crisandaniela/Generator-Semnal-OrCAD/Crisan_Diana_Daniela_2121.pdf

## GENERATOR DE SEMNAL TRIUNGHI-DREPTUNGHI

## 1. Introducere și Principiul de Funcționare

Generatoarele de semnal capabile să genereze simultan forme de undă triunghiulare și dreptunghiulare sunt utilizate frecvent în telecomunicații, circuite de testare și sisteme de achiziție de date. Proiectul constă în proiectarea, dimensionarea și simularea unui astfel de generator, respectând specificațiile tehnice impuse.
Conform temei de proiectare, circuitul trebuie alimentat simetric la ±16 V și să genereze semnale cu frecvența reglabilă în domeniul [11000 Hz; 25000 Hz], având amplitudinea semnalului triunghiular ajustabilă între 4 V și 8 V, respectiv între 2 V și 10 V pentru cel dreptunghiular.

Structura de bază folosește un circuit în buclă închisă compus din două etaje funcționale. Primul este un integrator inversor, adică un amplificator operațional cu un condensator pe bucla de reacție negativă, care transformă semnalul dreptunghiular de la intrare într-un triunghi la ieșire, prin integrarea curentului. Al doilea etaj este un trigger Schmitt neinversor, cu o buclă de reacție pozitivă, care detectează nivelurile de tensiune ale semnalului triunghiular și comută rapid ieșirea între saturație pozitivă și negativă.

Pentru a regla amplitudinile independent față de frecvență, la ieșirea fiecărui etaj a fost adăugat un divizor rezistiv cu potențiometru, urmat de un buffer. Tot montajul a fost implementat cu un singur circuit integrat TL084, care are 4 AO-uri într-o singură capsulă, alimentat simetric la ±16V, ceea ce a simplificat mult schema și a redus numărul de componente.

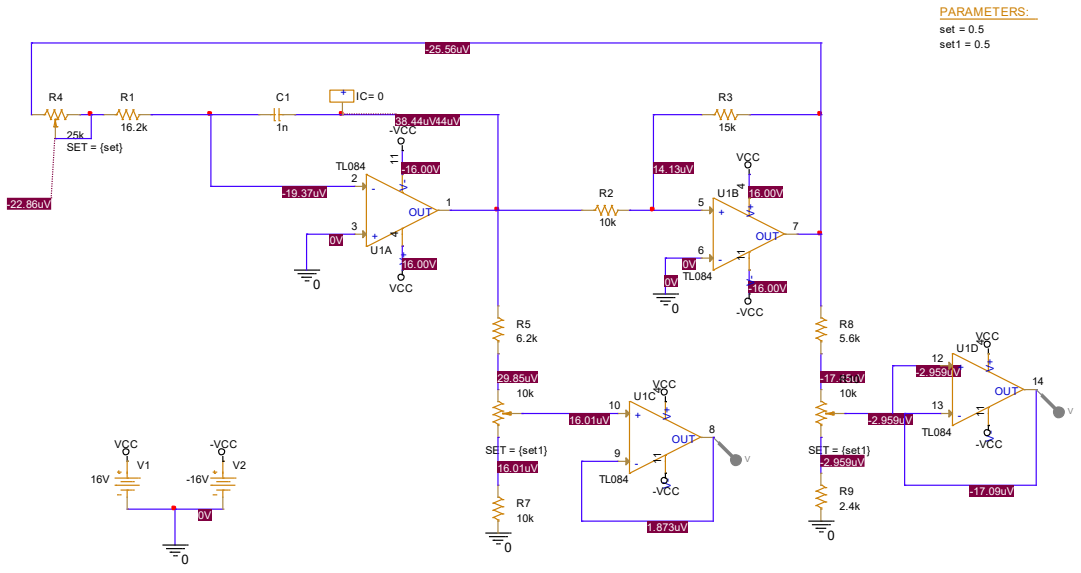
[picture p1: figure]
OUT; VCC; SET = {set1} -2.959uV; -VCC; SET = {set1}; 25k SET = {set}; PARAMETERS:; set = 0.5; set1 = 0.5

Figură 1. Schema electrică a generatorului de semnal triunghi-dreptunghi cu reglaj de frecvență și amplitudine.

## 2.Calculul și Dimensionarea Componentelor

Când este alimentat cu o tensiune de ±16 V, amplificatorul operațional de la ieșirea circuitului integrat TL084 poate ajunge la o tensiune maximă de saturație de aproximativ E ≈ 14,5 V, ținând cont de căderile de tensiune interne de pe tranzistoarele sale de ieșire.

### 2.1 Dimensionarea Pragurilor Comparatorului

Amplitudinea de vârf a semnalului triunghiular generat de circuitul oscilator (Vout1) depinde în totalitate de pragurile de comutare superior (Vps) și inferior (Vpj) ale trigger-ului Schmitt. Formula pentru stabilirea acestor limite este:

Vps,pj =

R1
R2
± E | (1)

Pentru a permite atenuarea ulterioară a semnalului la nivelul de vârf dorit de 8 V, am ales valorile standard R1 = 10 kΩ și R2 = 15 kΩ pentru rezistoarele din reacție. Introducând aceste valori în ecuația (1), amplitudinea inițială a semnalului triunghiular devine:

Vtri_brut =

10 kΩ
15 kΩ
- 14.5 V ≈ 9.66 V | (2)

### 2.2 Calculul Elementelor de Reglaj al Frecvenței

Perioada totală a semnalului generat (T) este suma timpilor de încărcare și descărcare ai condensatorului din integrator (T=T1 + T2). Conform ecuațiilor de funcționare ale integratorului ideal, frecvența de oscilație este exprimată prin relația:

f =

R2

4 ∙ R1 ∙ Rfrecv ∙ C

(3)

Pentru condensatorul de integrare am optat pentru valoarea standartizată C = 1 nF. Pentru a acoperi domeniul de frecvență impus (11000 Hz – 25000 Hz), rezistența echivalentă necesară reglajului frecvenței (Rfrecv) se calculează pentru ambele limite ale domeniului:

Rfrecv_fmax =

15 kΩ
4 ∙ 10 kΩ ∙ 25000 Hz ∙ 1 ∙ 10⁻⁹ F
= 15000 Ω = 15 kΩ | (4)

Rfrecv_fmin =

15 kΩ
4 ∙ 10 kΩ ∙ 11000 Hz ∙ 1 ∙ 10⁻⁹ F
≈ 34090 Ω ≈ 34.1 kΩ | (5)

Pentru implementarea rezistenței variabile Rfrecv, am folosit o configurație serie alcătuită dintr-un rezistor fix (Rfix) și un potențiometru (Pfrecv). În urma analizelor de reglaj fin realizate în simulator, pentru compensarea timpilor de comutare reali ai integratului TL084, valorile finale ale rezistenței fixe și ale potențiometrului sunt Rfix = 16.2 kΩ, respectiv Pfrecv = 25 kΩ. Prin variația cursorului între pozițiile extreme, rezistența totală se află în intervalul 16.2 kΩ - 41,2 kΩ, acoperind plaja de frecvențe cerută.

### 2.3 Dimensionarea Divizoarelor pentru Reglajul Amplitudinilor

Fiecare circuit de ajustare este alcătuit dintr-un divizor cu trei componente: o rezistență superioară (Rsus), un potențiometru central (P) și o rezistență inferioară (Rjos) conectată la masă. Sistemul general de ecuații care descrie tensiunea minimă și maximă culese de pe cursor este:

{

Vout_min = Vin ∙

Rjos

Rjos + P + Rsus

Vout_max = Vin ∙

P + Rjos

Rjos + P + Rsus

(6)

### 2.3.1 Reglajul Semnalului Dreptunghiular

Tensiunea de intrare în acest divizor este dată de amplitudinea semnalului dreptunghiului de la ieșirea comparatorului, Vin = 14,5 V. Înlocuind în sistemul (6), obținem:

{

2 V = 14.5 V ∙

R4
R3 + P + R4

10 V = 14.5 V ∙

P + R4
R3 + P + R4

(7)

Prin împărțirea celor două relații matematice, se determină raportul structural:

10 V
2 V

=

P + R4
R4

⇒ 5 =

P
R4

+ 1 ⇒ P = 4 ∙ R4

(8)

Am ales o valoare uzuală pentru potențiometru, P=10 kΩ. Din ecuația (8) rezultă R4 = 2,5 kΩ, optînd pentru valoarea standard apropiată R4 = 2,4 kΩ. Introducând aceste valori în prima ecuație a sistemului (7), obținem:

2 V = 14,5 V ∙

2,4 kΩ
R3 + 10 kΩ + 2,4 kΩ

⇒ 2 ∙ R3 + 24.8 = 34.8 ⇒ R3 = 5 kΩ (9)

Pentru o integrare eficientă în simularea Pspice, utilizând componente din seria comercială E12, valoarea folosită este R3 = 5,6 kΩ.

### 2.3.2 Reglajul Semnalului Triunghiular

Tensiunea de intrare de la ieșirea integratorului este Vin ≈ 9,66 V. Aplicând limitele de proiectare în ecuația divizorului obținem:

{

4 V = 9.66 V ∙

R6
R5 + P + R6

8 V = 9.66 V ∙

P + R6
R5 + P + R6

(10)

Raportul ecuațiilor elimină dependența de tensiunea de intrare:

8 V
4 V

=

P + R6
R6

⇒ 2 =

P
R6

+ 1 ⇒ P = R6

(11)

Alegând un potențiometru standard P=10 kΩ, rezultă că rezistorul inferior are valoarea R6 = 10 kΩ. Înlocuind mărimile în ecuația valorii maxime din sistemul (10), obținem valoarea teoretică pentru R5:

8 V = 9,66 V ∙

20 kΩ
R5 + 20 kΩ
⇒ 8 ∙ R5 + 160 = 193,2 ⇒ R5 = 4,15 kΩ | (12)

În urma rulării modelului de simulare transient, pentru a compensa comportamentul asimetric al curentului de polarizare și impedanța internă a etajului de saturație al AO, valoarea optimă determinată prin acord fin este R5 = 6,2 kΩ.

## 3. Analiza Performanței Circuitului în OrCad Pspice

## 3.1 Analiza în Domeniul Timp (Transient Analysis)

Simularea de tip Transient a fost configurată pentru un timp total de rulare Run to time = 1ms, utilizând un pas de calcul de rezoluție înaltă Maximum step size = 0.1us. A fost activată opțiunea SKIPBP (Skip initial transient bias point) pentru a asigura amorsarea naturală a oscilațiilor.
În această analiză, parametrii tuturor potențiometrelor au fost fixați la valoarea de mijloc, SET = 0.5 (50% din cursă). Vizualizarea nodurilor de ieșire arată că semnalele sunt generate corect.

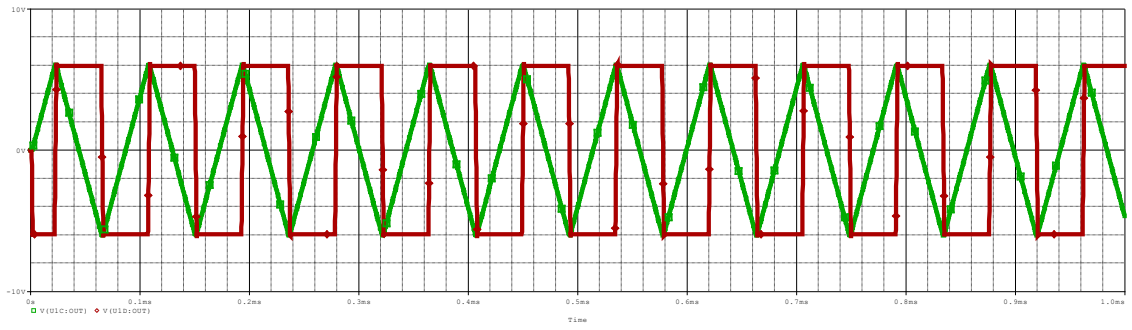
[picture p2: figure]
Time; V(U1C:OUT); V(U1D:OUT)

Figură 2. Formele de undă ale semnalelor de ieșire (Triunghi și Dreptunghi) pentru poziția mediană a potențiometrelor.

### 3.2 Demonstrarea Reglajului de Amplitudine (Analiză Parametrică)

Pentru a demonstra acoperirea intervalelor de amplitudine cerute (4 V – 8 V pentru semnalul triunghiular și 2 V – 10 V pentru semnalul dreptunghiular), am configurat o analiză parametrică. Parametrul asociat potențiometrelor de reglaj (set1) a luat valoarea 0 pentru obținerea amplitudinii maxime și valoarea 1 pentru amplitudinea minimă.

Pentru extragerea tensiunii de vârf am folosit funcția matematică:

Vp =

MAX(Vout) − MIN(Vout)
2

(13)

Această funcție a fost aplicată separat pe rezultatele analizei parametrice pentru ambele ieșiri. În cazul semnalului triunghiular, graficul demonstrează o variație liniară a amplitudinii, valorile la capetele cursei potențiometrului fiind de aproximativ 4 V și, respectiv, 8 V. Pentru semnalul dreptunghiular am observat o variație controlabilă, delimitată clar între limita inferioară de 2 V și cea superioară de aproximativ 10 V. Prin atingerea acestor praguri, rezultatele simulării validează ecuațiile divizoarelor rezistive calculate anterior.

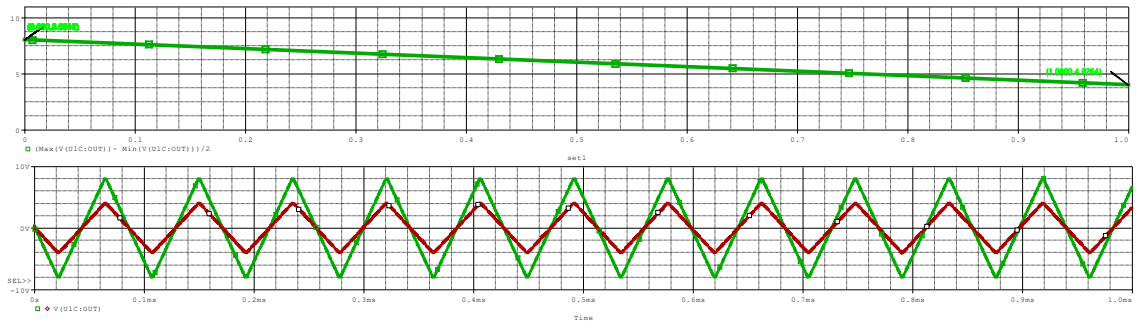
[picture p3: figure]
Time; V(U1C:OUT); SEL>>; set1; (Max(V(U1C:OUT))- Min(V(U1C:OUT)))/2

Figură 3 . Analiza parametrică a amplitudinii semnalului triunghiular în funcție de cursa potențiometrului.

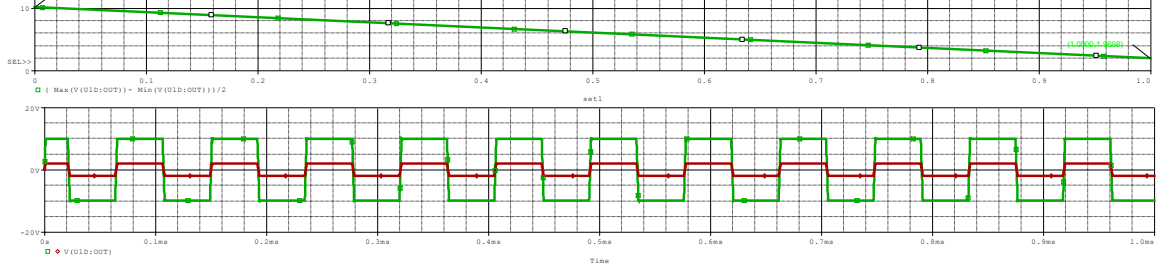
[picture p4: figure]
Time; V(U1D:OUT); set1; ( Max(V(U1D:OUT))- Min(V(U1D:OUT)))/2; SEL>>

Figură 4. Analiza parametrică a amplitudinii semnalului dreptunghiular în funcție de cursa potențiometrului.

### 3.3 Demonstrarea Reglajului de Frecvență

Pentru a valida sistemul de reglaj al frecvenței, am efectuat o variație parametrică a potențiometrului din bucla integratorului. Frecvența a fost extrasă aplicând funcția
1
Period(V(dreptungℎi))

pe axa Y, raportată la valoarea variabilei SET pe axa X.Rezultatele obținute demonstrează o caracteristică de acord stabilă. Curba obținută atinge o frecvență minimă de aproximativ 11 kHz la o extremă și depășește 25 kHz la cealaltă extremă.

Figură 5. Variația frecvenței de oscilație în domeniul cerut (11 kHz - 25 kHz)

20

(0.000,10.182)

set

0 | 0.1 | 0.2 | 0.3 | 0.4 | 0.5 | 0.6 | 0.7 | 0.8 | 0.9 | 1.0 | 1.1
| 1/ Period(V(U1B:OUT))

10K

20K

30K

40K

(1.0000,25.550K)

(0.000,11.112K)

### 3.4 Analiza Statistică a Circuitului: Monte Carlo și Worst Case

Pentru a evalua fiabilitatea circuitului la variațiile inevitabile ale parametrilor de fabricație, am efectuat simulări statistice avansate de tip Monte Carlo și Worst Case. În cadrul modelului PSpice, rezistoarelor din structura buclei oscilatoare (etajul integrator și trigger-ul Schmitt) le-am atribuit un parametru de toleranță standard comercială de 5%.

### 3.4.1 Analiza Worst Case

Această analiză are scopul de a determina limitele maxime ale deviațiilor semnalului de ieșire în scenariul în care abaterile tuturor componentelor se însumează în cel mai nefavorabil mod posibil. Simularea relevă ecartul maxim de deplasare a frecvenței și a amplitudinilor. Rezultatele demonstrează că, deși există o ușoară deplasare temporală și de amplitudine (vizibilă pe grafic sub forma a două forme de undă decalate), circuitul își păstrează stabilitatea, bucla oscilează continuu, iar ieșirea nu se blochează, confirmând viabilitatea circuitului.

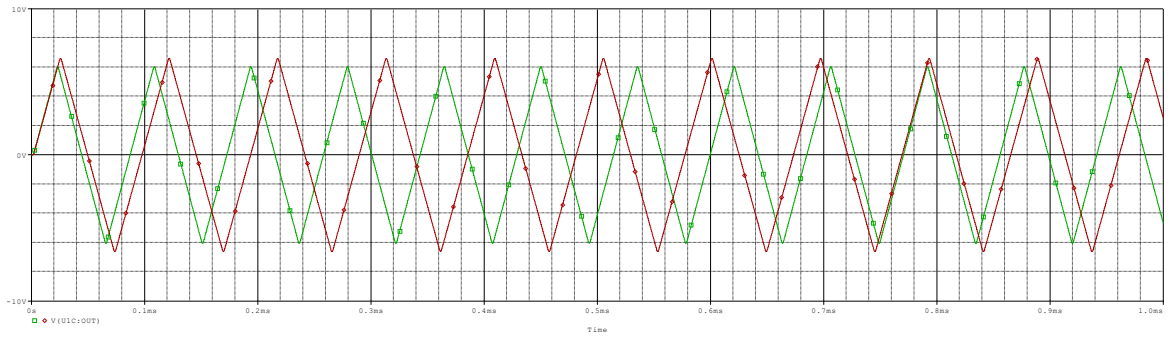
[picture p5: figure]
Time; V(U1C:OUT)

Figură 6. Analiza Worst Case a semnalului de ieșire comparativ cu rularea nominală.

### 3.4.2 Analiza Monte Carlo

Pentru a observa distribuția comportamentului circuitului într-un lot de producție, am realizat o analiză Monte Carlo cu un număr de N = 50 de rulări. Simulatorul a variat aleatoriu valorile rezistențelor în limitele toleranței de 5%, generând o suprapunere a formelor de undă rezultate. Variația obținută confirmă faptul că deviațiile sunt ținute sub control de rețeaua de reacție. Probabilitatea ca parametrii semnalului să depășească cerințele proiectului datorită componentelor fizice este foarte redusă.

Pentru a înțelege exact cum influențează toleranțele parametrii de ieșire, am procesat datele folosind instrumentul Performance Analysis. Am extras amplitudinea maximă a semnalului triunghiular aplicând funcția Max(V(U1C:OUT)) pe tot setul de date obținut. Rezultatele acestei analize statistice sunt prezentate sub forma unei histograme.

Figură 7. Histograma distribuției statistice a amplitudinii semnalului triunghiular

Datele extrase din histogramă arată o distribuție de tip Gauss centrată în jurul valorii medii de aproximativ 5.98 V. Având în vedere că pentru această simulare cursorul potențiometrului de amplitudine a fost fixat la jumătatea cursei sale (SET = 0.5), valoarea ideală teoretică era de exact 6 V. Media statistică coincide practic cu valoarea teoretică, confirmând validitatea și acuratețea ecuațiilor de proiectare ale divizorului de tensiune. Variația absolută a amplitudinii pe lotul de 50 de rulări s-a încadrat între 5.55 V și 6.47 V. Aceste deviații de aproximativ ±0.5 V față de valoarea centrală arată că circuitul nu este sensibil la toleranțele pasive de 5%, designul fiind viabil pentru producție și implementare fizică.

Max(V(U1C:OUT))

5.4 | 5.5 | 5.6 | 5.7 | 5.8 | 5.9 | 6.0 | 6.1 | 6.2 | 6.3 | 6.4 | 6.5 | 6.6

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
n samples | = 50 | n divisions = 10 | mean | = 5.98487 | sigma | = 0.22507 | minimum | = 5.55738 | 10th %ile | = 5.66163 | median | = 5.99723 | 90th %ile | = 6.29086 | maximum | = 6.47033 | 3*sigma | = 0.67521

## 4. Concluzii

Generatorul de semnal triunghi-dreptunghi proiectat respectă toate specificațiile din tema de proiectare. Întreaga schemă a fost implementată cu un singur TL084, ceea ce a redus numărul de componente și a simplificat cablajul.

Principala observație din acest proiect a fost că valorile calculate teoretic nu au corespuns direct cu rezultatele din simulator. TL084 are întârzieri interne și limitări de Slew Rate care decalează frecvența reală față de cea calculată, motiv pentru care a trebuit să ajustez valorile componentelor prin fine-tuning în Pspice. De exemplu, Rfix a fost stabilit la 16.2 kΩ în locul valorii inițiale de 15 kΩ.

Testele Worst Case și Monte Carlo au arătat că schema funcționează corect chiar și cu componente la limita toleranței de 5%. Bucla oscilează stabil, amplitudinile se încadrează în specificașii și ieșirea nu se blochează. Circuitul este funcțional și poate fi asamblat direct pe un PCB fără modificări suplimentare.

## 5. Bibliografie

[1] O. Pop, Circuite Electronice Fundamentale - Generator de semnal triunghiular și dreptunghiular, Note de curs, Universitatea Tehnică din Cluj-Napoca, Facultatea de Electronică, Telecomunicații și Tehnologia Informației.
[2] „TL084 JFET-Input Operational Amplifiers data sheet”, Texas Instruments.
[3] PSpice A/D User's Guide, Cadence Design Systems.
