crisandaniela/Generator-Semnal-OrCAD/(list of files, drawings)

Other design files:
GTLV.DSN
GTLV.opj
